t0mer/hebrew-time-rtc/Arduino/Clock/secrets.h

#pragma once

// secrets.h is no longer required.
// WiFi credentials are not needed — the device runs its own Access Point.
//
// AP SSID:     HebrewClock   (configurable in Clock.ino via AP_SSID)
// AP Password: none (open)   (configurable via AP_PASSWORD)
// Web UI:      http://192.168.4.1
